SoTWild/Film-Processer/Hardware/3D/Render_Film_Processer_PCB_1.0.png

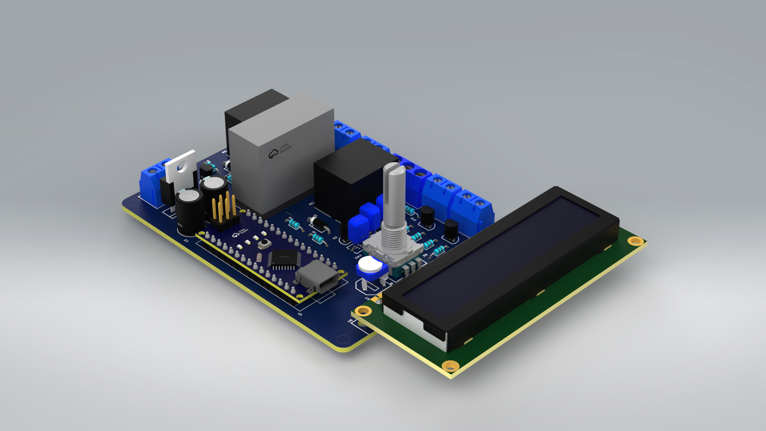
Hardware/3D/Render_Film_Processer_PCB_1.0.png
