SoTWild/Film-Processer/Hardware/3D/Render_Film_Processer_PCB_2.0.jpg

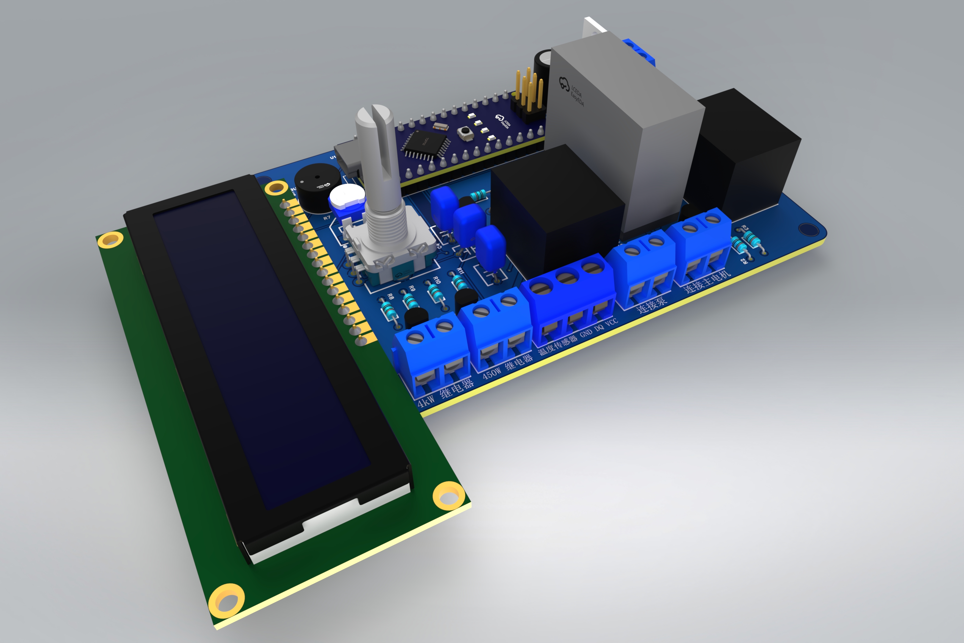
Hardware/3D/Render_Film_Processer_PCB_2.0.jpg
