SoTWild/Film-Processer/Hardware/PCB/BOM_Board1_Schematic1.xlsx

No. | Quantity | Designator
1 | 39 | BUZZER1,C1,C2,C3,C4,C5,D1,D2,D3,P1,P2,P3,P4,P5,Q1,Q2,Q3,Q4,Q5,R1,R2,R3,R4,R5,R6,R7,R8,R9,R10,R11,R12,RELAY1,RELAY2,RELAY3,SW3,U1,U3,U6,U7
