SoTWild/Film-Processer/Hardware/PCB/PCB_PCB_2.0.pdf

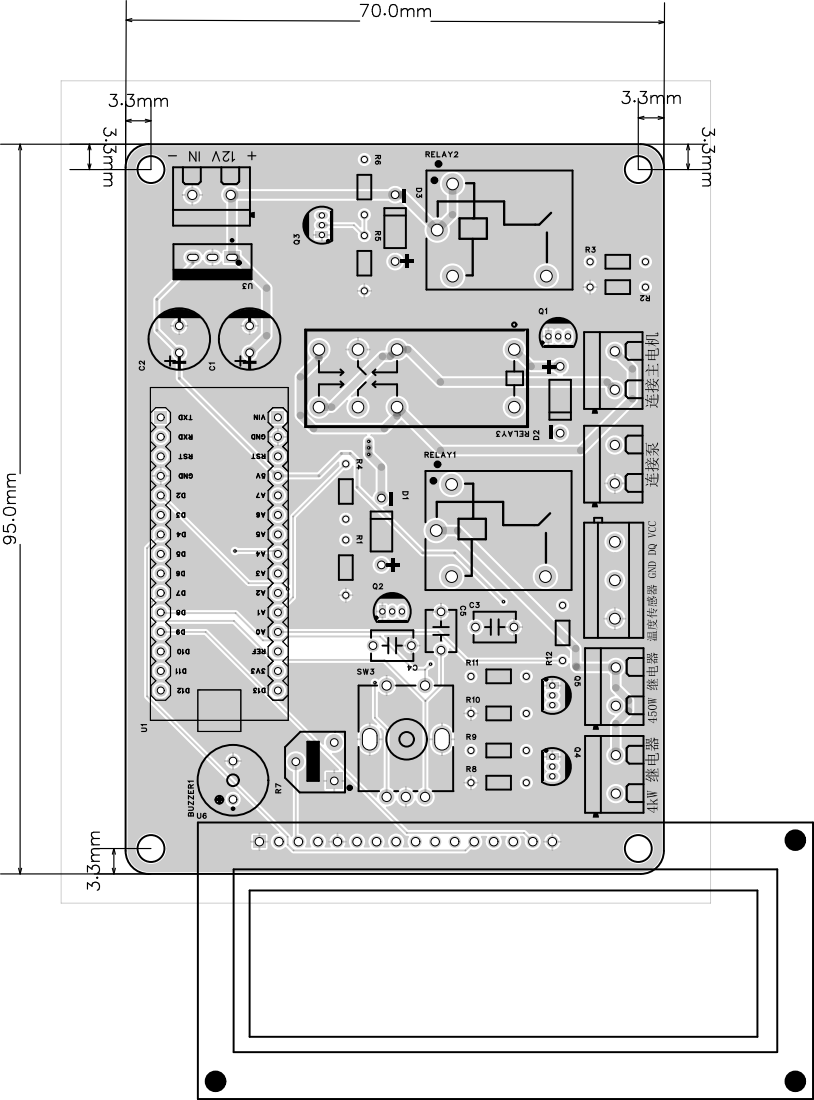
[picture p6: page 1]

连接泵 连接主电机 4kW 继电器 450W 继电器

温度传感器 GND DQ VCC

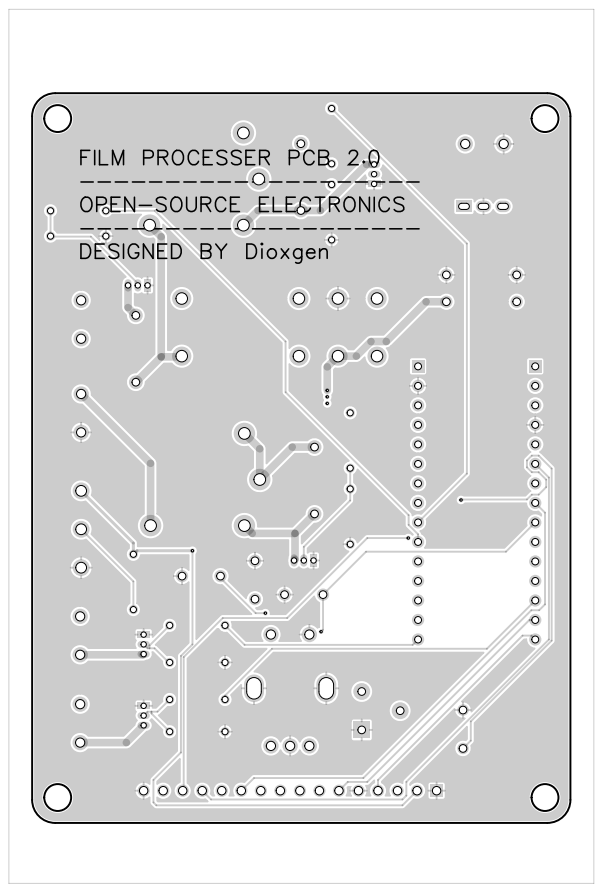
[picture p7: page 2]

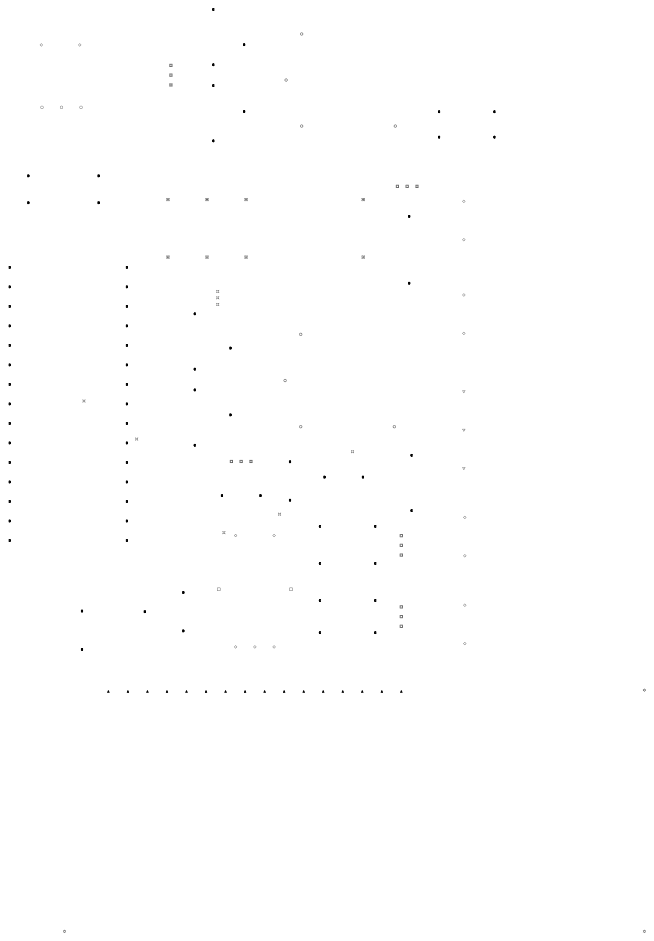
[picture p8: page 3]
