SoTWild/Film-Processer/(notices)

Notices in the files:
README.md:
License: GPL
